BlackBrix/AKdiuno-V3/hardware/dual AK4493 DAC/XMOS_AK4118_1-Large.jpg

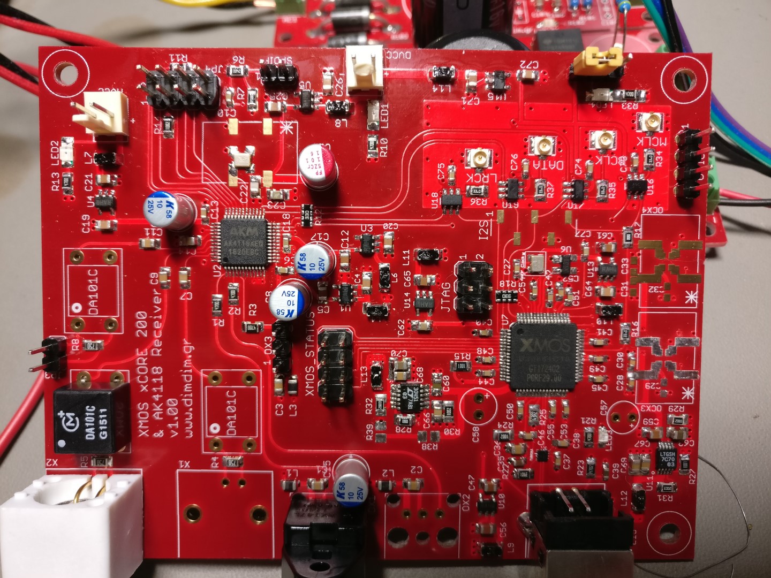
hardware/dual AK4493 DAC/XMOS_AK4118_1-Large.jpg
