BlackBrix/AKdiuno-V3/hardware/controller/STM32_MB_PCB_v36.png

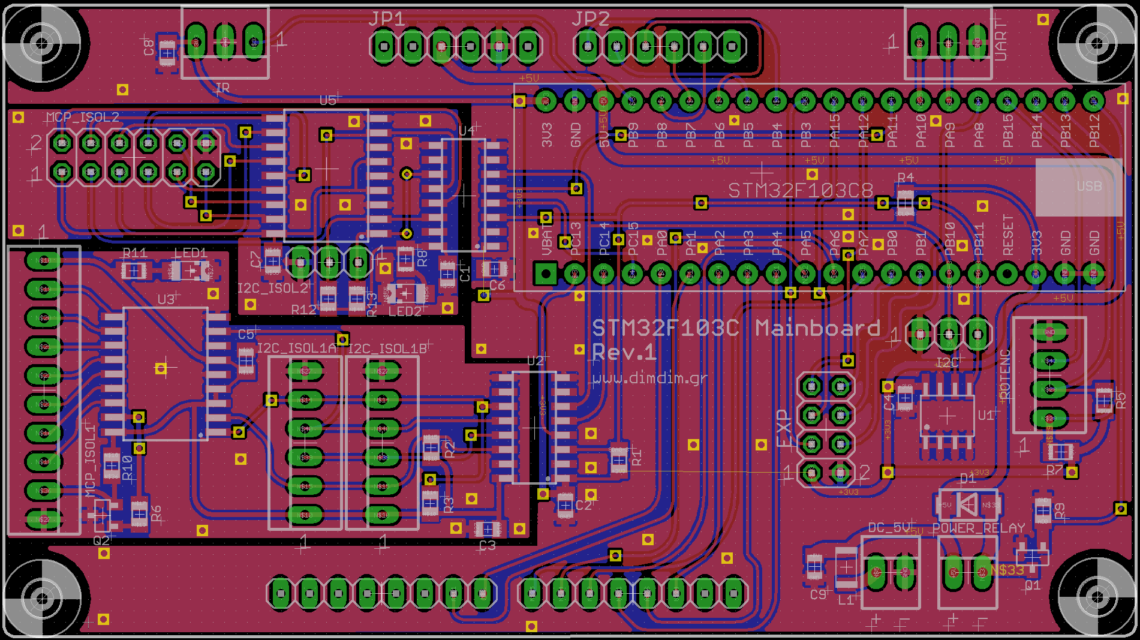
hardware/controller/STM32_MB_PCB_v36.png
