BlackBrix/AKdiuno-V3/hardware/controller/STM32_MB_Topo_v36.png

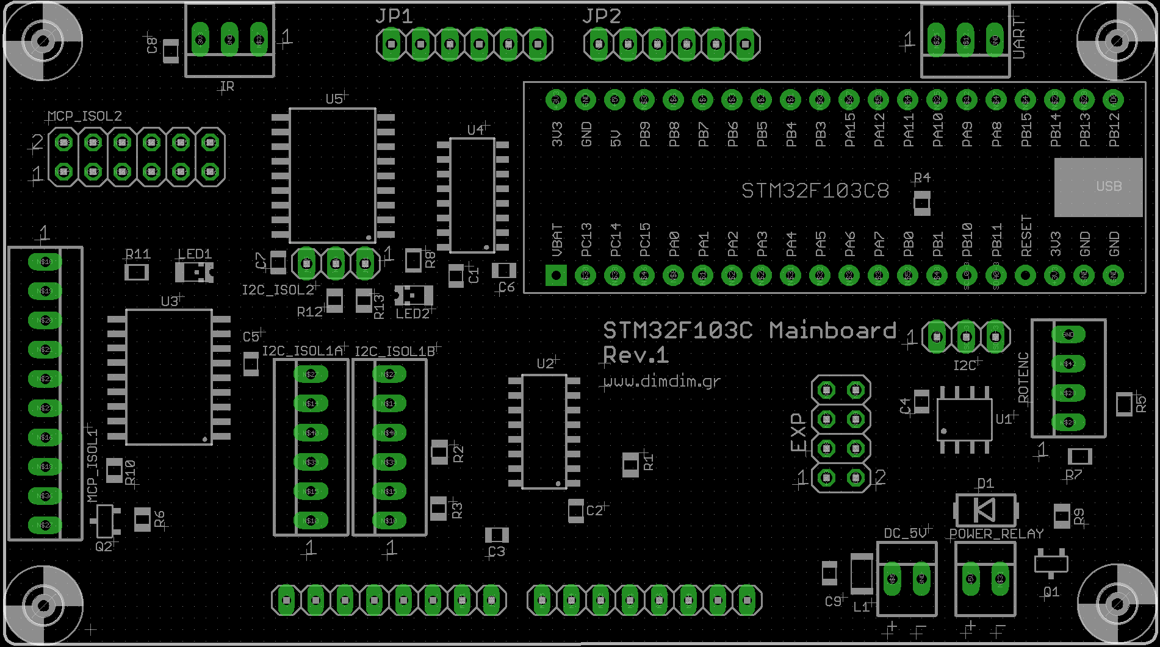
hardware/controller/STM32_MB_Topo_v36.png
