BlackBrix/AKdiuno-V3/hardware/dual AK4493 DAC/AK4493-v1.64-schematic.png

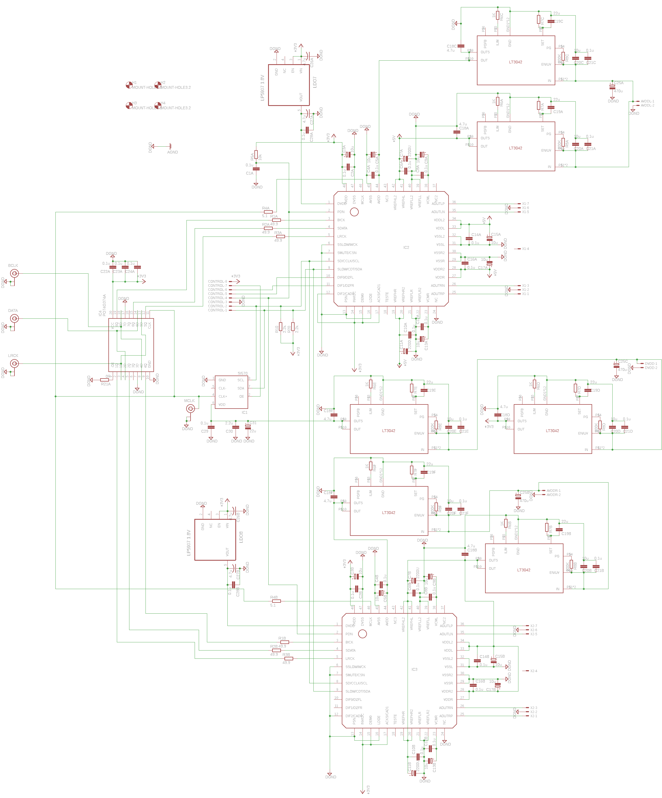
hardware/dual AK4493 DAC/AK4493-v1.64-schematic.png
