BlackBrix/AKdiuno-V3/hardware/dual AK4493 DAC/Dual_Mono_AK4493_3-Large.jpg

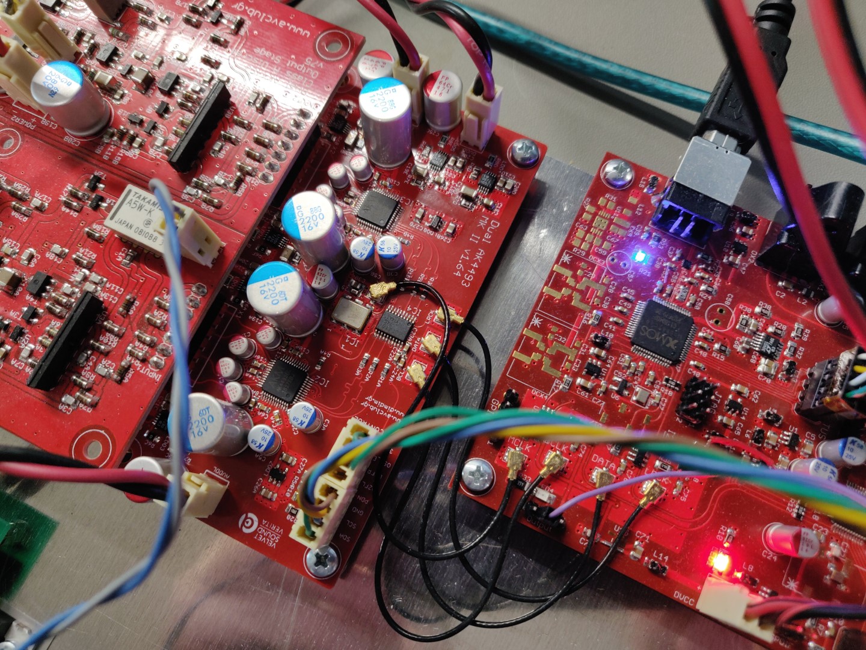
hardware/dual AK4493 DAC/Dual_Mono_AK4493_3-Large.jpg
