BlackBrix/AKdiuno-V3/hardware/Output Stage/AK4490_discreet_1-Large.jpg

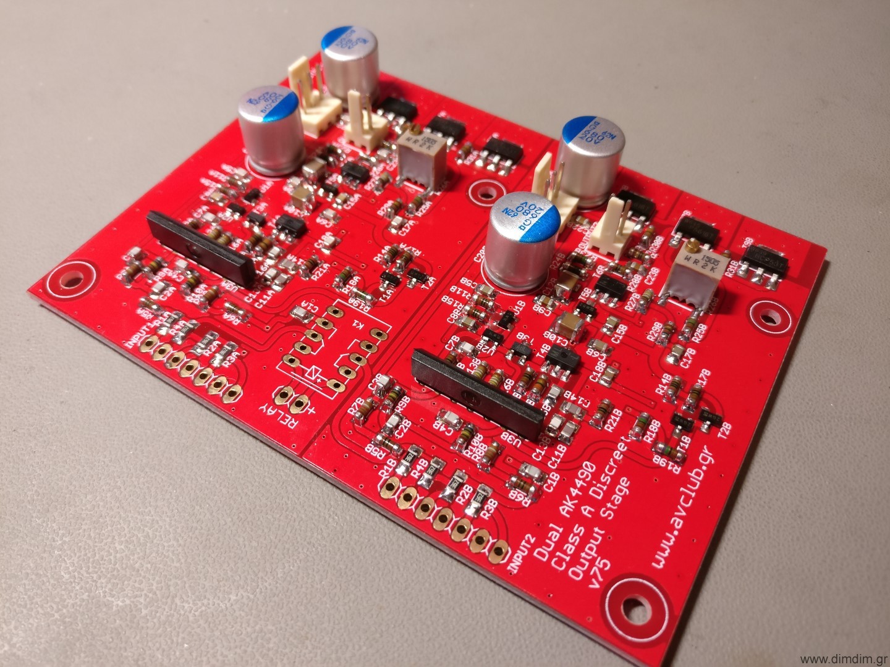
hardware/Output Stage/AK4490_discreet_1-Large.jpg
