BlackBrix/AKdiuno-V3/hardware/Output Stage/Discreet_v76_pcb.png

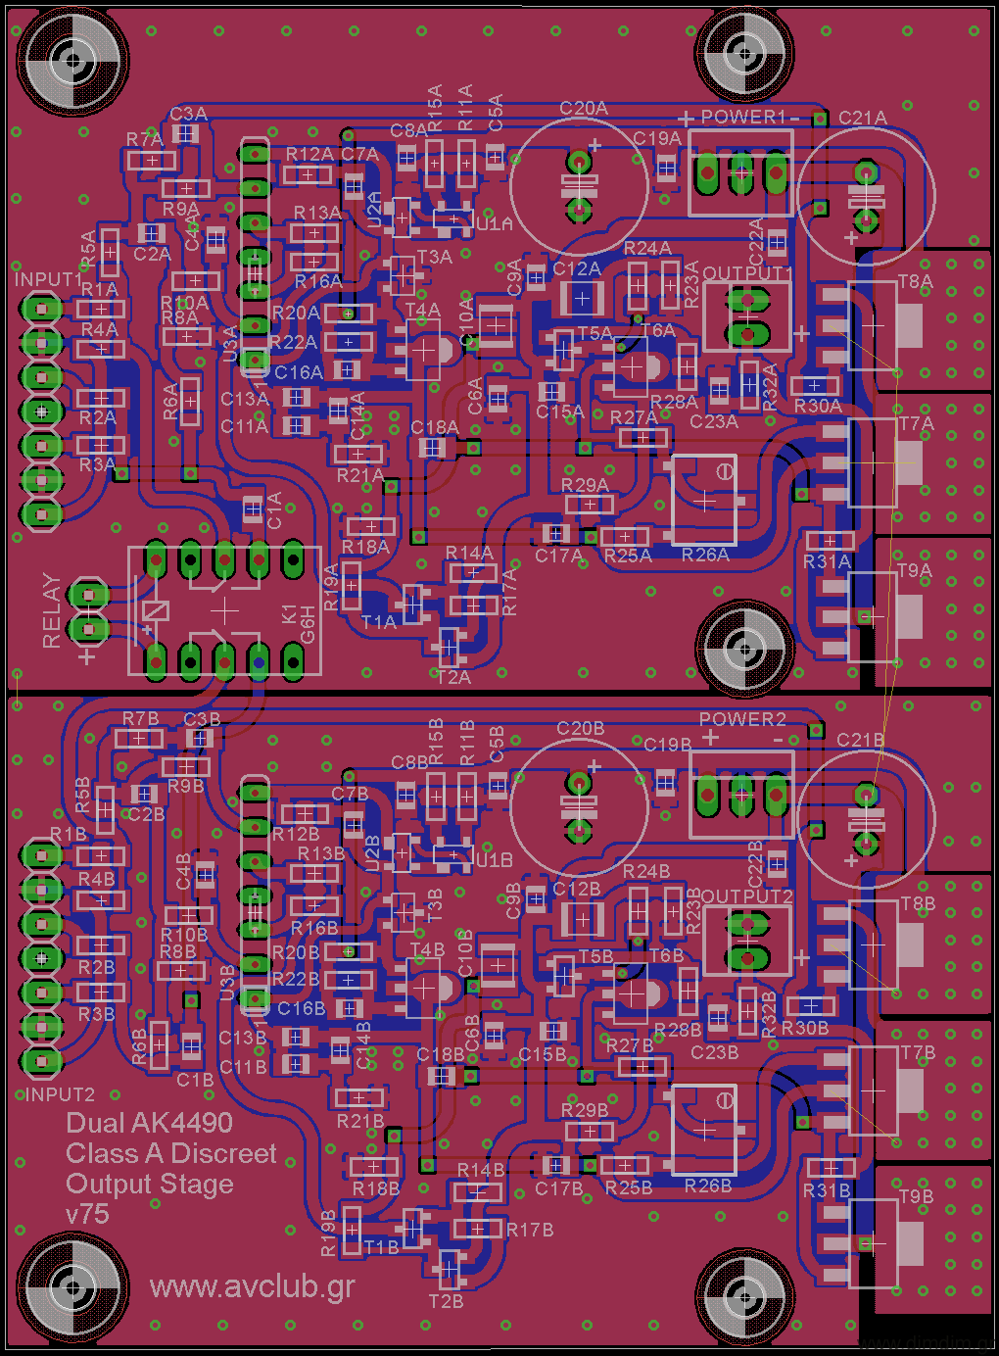
hardware/Output Stage/Discreet_v76_pcb.png
