BlackBrix/AKdiuno-V3/hardware/Output Stage/Discreet_v76_schem.png

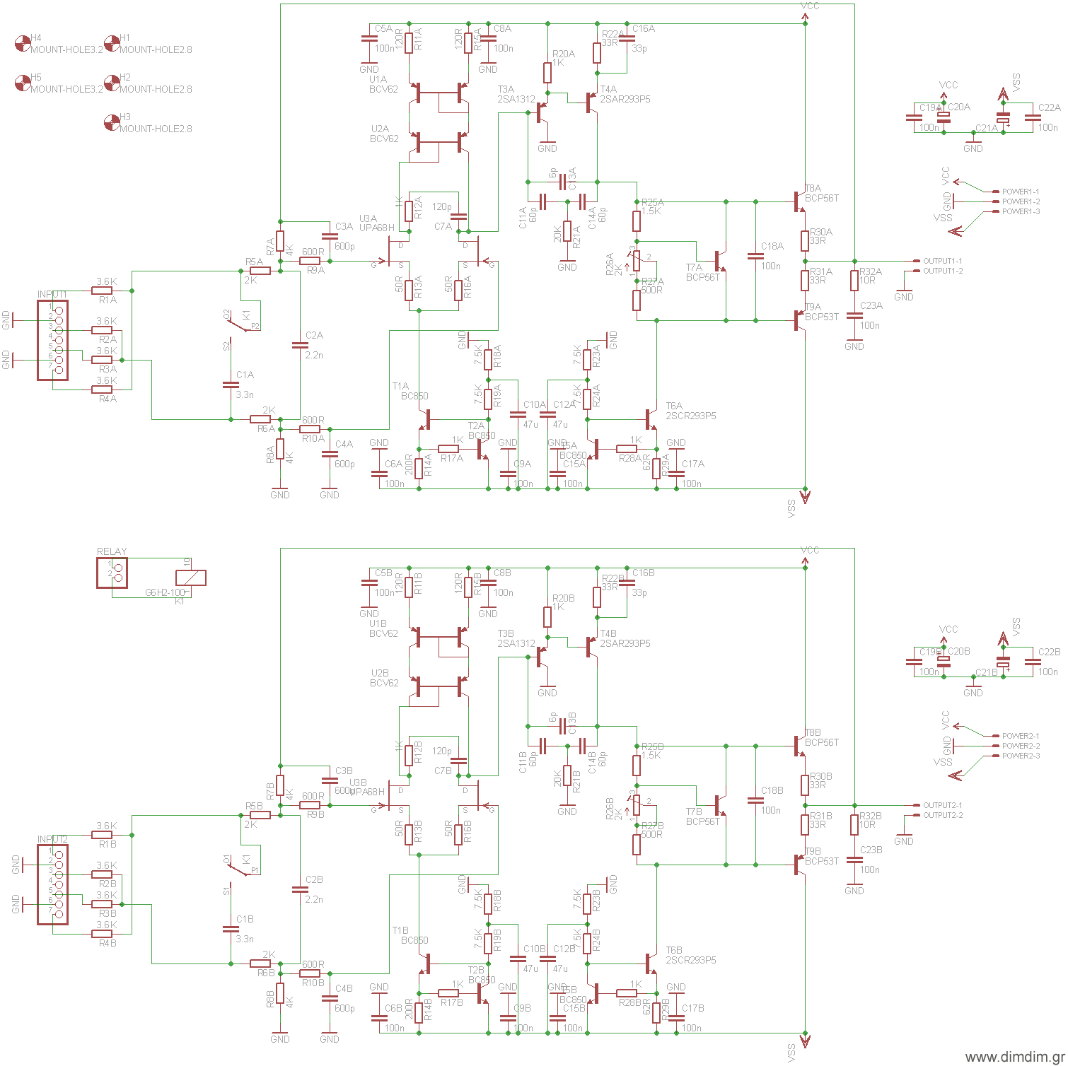
hardware/Output Stage/Discreet_v76_schem.png
