BlackBrix/AKdiuno-V3/hardware/Output Stage/BOM_output_stage.xlsx

Part | Value | Device | Package | Description | Mouser Part No. | Notes
Capacitors
C1A | 3.3n | C-EUC0805K | C0805K | Multilayer Ceramic Capacitors MLCC - SMD/SMT 50volts 3300pF 5% C0G | 80-C0805C332J5G | Critical value. +/-5% from initial value if it is necessary
C1B | 3.3n | C-EUC0805K | C0805K | Multilayer Ceramic Capacitors MLCC - SMD/SMT 50volts 3300pF 5% C0G | 80-C0805C332J5G | Critical value. +/-5% from initial value if it is necessary
C2A | 2.2n | C-EUC0805K | C0805K | Multilayer Ceramic Capacitors MLCC - SMD/SMT 50V 0.0022uF 5% C0G | 80-C0805C222J5GACTU | Critical value. +/-5% from initial value if it is necessary
C2B | 2.2n | C-EUC0805K | C0805K | Multilayer Ceramic Capacitors MLCC - SMD/SMT 50V 0.0022uF 5% C0G | 80-C0805C222J5GACTU | Critical value. +/-5% from initial value if it is necessary
C3A | 620p | C-EUC0805K | C0805K | Multilayer Ceramic Capacitors MLCC - SMD/SMT 50volts 620pF C0G 5% | 80-C0805C621J5G | Critical value. +/-5% from initial value if it is necessary
C3B | 620p | C-EUC0805K | C0805K | Multilayer Ceramic Capacitors MLCC - SMD/SMT 50volts 620pF C0G 5% | 80-C0805C621J5G | Critical value. +/-5% from initial value if it is necessary
C4A | 620p | C-EUC0805K | C0805K | Multilayer Ceramic Capacitors MLCC - SMD/SMT 50volts 620pF C0G 5% | 80-C0805C621J5G | Critical value. +/-5% from initial value if it is necessary
C4B | 620p | C-EUC0805K | C0805K | Multilayer Ceramic Capacitors MLCC - SMD/SMT 50volts 620pF C0G 5% | 80-C0805C621J5G | Critical value. +/-5% from initial value if it is necessary
C5A | 100n | C-EUC0805K | C0805K | Multilayer Ceramic Capacitors MLCC - SMD/SMT 16volts 0.1uF X7R 10% | 80-C0805C104K4R
C5B | 100n | C-EUC0805K | C0805K | Multilayer Ceramic Capacitors MLCC - SMD/SMT 16volts 0.1uF X7R 10% | 80-C0805C104K4R
C6A | 100n | C-EUC0805K | C0805K | Multilayer Ceramic Capacitors MLCC - SMD/SMT 16volts 0.1uF X7R 10% | 80-C0805C104K4R
C6B | 100n | C-EUC0805K | C0805K | Multilayer Ceramic Capacitors MLCC - SMD/SMT 16volts 0.1uF X7R 10% | 80-C0805C104K4R
C7A | 120p | C-EUC0805K | C0805K | Multilayer Ceramic Capacitors MLCC - SMD/SMT 50volts 120pF C0G 2% | 80-C0805C121G5G | Critical value. +/-5% from initial value if it is necessary
C7B | 120p | C-EUC0805K | C0805K | Multilayer Ceramic Capacitors MLCC - SMD/SMT 50volts 120pF C0G 2% | 80-C0805C121G5G | Critical value. +/-5% from initial value if it is necessary
C8A | 100n | C-EUC0805K | C0805K | Multilayer Ceramic Capacitors MLCC - SMD/SMT 16volts 0.1uF X7R 10% | 80-C0805C104K4R
C8B | 100n | C-EUC0805K | C0805K | Multilayer Ceramic Capacitors MLCC - SMD/SMT 16volts 0.1uF X7R 10% | 80-C0805C104K4R
C9A | 100n | C-EUC0805K | C0805K | Multilayer Ceramic Capacitors MLCC - SMD/SMT 16volts 0.1uF X7R 10% | 80-C0805C104K4R
C9B | 100n | C-EUC0805K | C0805K | Multilayer Ceramic Capacitors MLCC - SMD/SMT 16volts 0.1uF X7R 10% | 80-C0805C104K4R
C10A | 47u | C-EUC1210K | C1210K | Multilayer Ceramic Capacitors MLCC - SMD/SMT 47uF 10V X7R +/-10% 1210 Gen Purp | 963-LMK325B7476KM-PR
C10B | 47u | C-EUC1210K | C1210K | Multilayer Ceramic Capacitors MLCC - SMD/SMT 47uF 10V X7R +/-10% 1210 Gen Purp | 963-LMK325B7476KM-PR
C11A | 62p | C-EUC0805K | C0805K | Multilayer Ceramic Capacitors MLCC - SMD/SMT 50volts 62pF C0G 5% | 80-C0805C620J5G | Critical value. +/-5% from initial value if it is necessary
C11B | 62p | C-EUC0805K | C0805K | Multilayer Ceramic Capacitors MLCC - SMD/SMT 50volts 62pF C0G 5% | 80-C0805C620J5G | Critical value. +/-5% from initial value if it is necessary
C12A | 47u | C-EUC1210K | C1210K | Multilayer Ceramic Capacitors MLCC - SMD/SMT 47uF 10V X7R +/-10% 1210 Gen Purp | 963-LMK325B7476KM-PR
C12B | 47u | C-EUC1210K | C1210K | Multilayer Ceramic Capacitors MLCC - SMD/SMT 47uF 10V X7R +/-10% 1210 Gen Purp | 963-LMK325B7476KM-PR
C13A | 6p | C-EUC0805K | C0805K | Multilayer Ceramic Capacitors MLCC - SMD/SMT 50volts 6.2pF C0G 0.5% | 80-C0805C629D5G | Critical value. +/-5% from initial value if it is necessary
C13B | 6p | C-EUC0805K | C0805K | Multilayer Ceramic Capacitors MLCC - SMD/SMT 50volts 6.2pF C0G 0.5% | 80-C0805C629D5G | Critical value. +/-5% from initial value if it is necessary
C14A | 62p | C-EUC0805K | C0805K | Multilayer Ceramic Capacitors MLCC - SMD/SMT 50volts 62pF C0G 5% | 80-C0805C620J5G | Critical value. +/-5% from initial value if it is necessary
C14B | 62p | C-EUC0805K | C0805K | Multilayer Ceramic Capacitors MLCC - SMD/SMT 50volts 62pF C0G 5% | 80-C0805C620J5G | Critical value. +/-5% from initial value if it is necessary
C15A | 100n | C-EUC0805K | C0805K | Multilayer Ceramic Capacitors MLCC - SMD/SMT 16volts 0.1uF X7R 10% | 80-C0805C104K4R
C15B | 100n | C-EUC0805K | C0805K | Multilayer Ceramic Capacitors MLCC - SMD/SMT 16volts 0.1uF X7R 10% | 80-C0805C104K4R
C16A | 33p | C-EUC0805K | C0805K | Multilayer Ceramic Capacitors MLCC - SMD/SMT 100volts 33pF 5% C0G | 80-C0805C330J1GAC | Critical value. +/-5% from initial value if it is necessary
C16B | 33p | C-EUC0805K | C0805K | Multilayer Ceramic Capacitors MLCC - SMD/SMT 100volts 33pF 5% C0G | 80-C0805C330J1GAC | Critical value. +/-5% from initial value if it is necessary
C17A | 100n | C-EUC0805K | C0805K | Multilayer Ceramic Capacitors MLCC - SMD/SMT 16volts 0.1uF X7R 10% | 80-C0805C104K4R
C17B | 100n | C-EUC0805K | C0805K | Multilayer Ceramic Capacitors MLCC - SMD/SMT 16volts 0.1uF X7R 10% | 80-C0805C104K4R
C18A | 100n | C-EUC0805K | C0805K | Multilayer Ceramic Capacitors MLCC - SMD/SMT 16volts 0.1uF X7R 10% | 80-C0805C104K4R
C18B | 100n | C-EUC0805K | C0805K | Multilayer Ceramic Capacitors MLCC - SMD/SMT 16volts 0.1uF X7R 10% | 80-C0805C104K4R
C19A | 100n | C-EUC0805K | C0805K | Multilayer Ceramic Capacitors MLCC - SMD/SMT 16volts 0.1uF X7R 10% | 80-C0805C104K4R
C19B | 100n | C-EUC0805K | C0805K | Multilayer Ceramic Capacitors MLCC - SMD/SMT 16volts 0.1uF X7R 10% | 80-C0805C104K4R
C20A | 680u | CPOL-EUE3.5-10 | E3,5-10 | Aluminium Organic Polymer Capacitors 20Volts 680uF 0.2 | 661-APSG200E681MJB5S
C20B | 680u | CPOL-EUE3.5-10 | E3,5-10 | Aluminium Organic Polymer Capacitors 20Volts 680uF 0.2 | 661-APSG200E681MJB5S
C21A | 680u | CPOL-EUE3.5-10 | E3,5-10 | Aluminium Organic Polymer Capacitors 20Volts 680uF 0.2 | 661-APSG200E681MJB5S
C21B | 680u | CPOL-EUE3.5-10 | E3,5-10 | Aluminium Organic Polymer Capacitors 20Volts 680uF 0.2 | 661-APSG200E681MJB5S
C22A | 100n | C-EUC0805K | C0805K | Multilayer Ceramic Capacitors MLCC - SMD/SMT 16volts 0.1uF X7R 10% | 80-C0805C104K4R
C22B | 100n | C-EUC0805K | C0805K | Multilayer Ceramic Capacitors MLCC - SMD/SMT 16volts 0.1uF X7R 10% | 80-C0805C104K4R
C23A | 100n | C-EUC0805K | C0805K | Multilayer Ceramic Capacitors MLCC - SMD/SMT 16volts 0.1uF X7R 10% | 80-C0805C104K4R
C23B | 100n | C-EUC0805K | C0805K | Multilayer Ceramic Capacitors MLCC - SMD/SMT 16volts 0.1uF X7R 10% | 80-C0805C104K4R
Resistors
R1A | 3.6K | R-EU_MELF0204W | MINI_MELF-0204W | MELF Resistors 0.4W 3.6Kohms 1% 0204 MELF 150V 50ppm | 594-MMA02040C3601FB3 | Critical value. +/-10% from initial value if it is necessary
R1B | 3.6K | R-EU_MELF0204W | MINI_MELF-0204W | MELF Resistors 0.4W 3.6Kohms 1% 0204 MELF 150V 50ppm | 594-MMA02040C3601FB3 | Critical value. +/-10% from initial value if it is necessary
R2A | 3.6K | R-EU_MELF0204W | MINI_MELF-0204W | MELF Resistors 0.4W 3.6Kohms 1% 0204 MELF 150V 50ppm | 594-MMA02040C3601FB3 | Critical value. +/-10% from initial value if it is necessary
R2B | 3.6K | R-EU_MELF0204W | MINI_MELF-0204W | MELF Resistors 0.4W 3.6Kohms 1% 0204 MELF 150V 50ppm | 594-MMA02040C3601FB3 | Critical value. +/-10% from initial value if it is necessary
R3A | 3.6K | R-EU_MELF0204W | MINI_MELF-0204W | MELF Resistors 0.4W 3.6Kohms 1% 0204 MELF 150V 50ppm | 594-MMA02040C3601FB3 | Critical value. +/-10% from initial value if it is necessary
R3B | 3.6K | R-EU_MELF0204W | MINI_MELF-0204W | MELF Resistors 0.4W 3.6Kohms 1% 0204 MELF 150V 50ppm | 594-MMA02040C3601FB3 | Critical value. +/-10% from initial value if it is necessary
R4A | 3.6K | R-EU_MELF0204W | MINI_MELF-0204W | MELF Resistors 0.4W 3.6Kohms 1% 0204 MELF 150V 50ppm | 594-MMA02040C3601FB3 | Critical value. +/-10% from initial value if it is necessary
R4B | 3.6K | R-EU_MELF0204W | MINI_MELF-0204W | MELF Resistors 0.4W 3.6Kohms 1% 0204 MELF 150V 50ppm | 594-MMA02040C3601FB3 | Critical value. +/-10% from initial value if it is necessary
R5A | 2K | R-EU_MELF0204W | MINI_MELF-0204W | MELF Resistors 0.4W 2Kohms 1% 0204 MELF 200V 50ppm | 594-MMA02040C2001FB3 | Critical value. +/-5% from initial value if it is necessary
R5B | 2K | R-EU_MELF0204W | MINI_MELF-0204W | MELF Resistors 0.4W 2Kohms 1% 0204 MELF 200V 50ppm | 594-MMA02040C2001FB3 | Critical value. +/-5% from initial value if it is necessary
R6A | 2K | R-EU_MELF0204W | MINI_MELF-0204W | MELF Resistors 0.4W 2Kohms 1% 0204 MELF 200V 50ppm | 594-MMA02040C2001FB3 | Critical value. +/-5% from initial value if it is necessary
R6B | 2K | R-EU_MELF0204W | MINI_MELF-0204W | MELF Resistors 0.4W 2Kohms 1% 0204 MELF 200V 50ppm | 594-MMA02040C2001FB3 | Critical value. +/-5% from initial value if it is necessary
R7A | 4K | R-EU_MELF0204W | MINI_MELF-0204W | MELF Resistors 0.4W 4.02Kohms 1% 0204 MELF 200V 50ppm | 594-MMA02040C4021FB3 | Critical value. +/-5% from initial value if it is necessary
R7B | 4K | R-EU_MELF0204W | MINI_MELF-0204W | MELF Resistors 0.4W 4.02Kohms 1% 0204 MELF 200V 50ppm | 594-MMA02040C4021FB3 | Critical value. +/-5% from initial value if it is necessary
R8A | 4K | R-EU_MELF0204W | MINI_MELF-0204W | MELF Resistors 0.4W 4.02Kohms 1% 0204 MELF 200V 50ppm | 594-MMA02040C4021FB3 | Critical value. +/-5% from initial value if it is necessary
R8B | 4K | R-EU_MELF0204W | MINI_MELF-0204W | MELF Resistors 0.4W 4.02Kohms 1% 0204 MELF 200V 50ppm | 594-MMA02040C4021FB3 | Critical value. +/-5% from initial value if it is necessary
R9A | 600R | R-EU_MELF0204W | MINI_MELF-0204W | MELF Resistors 0.4W 604ohms 1% 0204 MELF 200V 50ppm | 594-MMA02040C6040FB3 | Critical value. +/-5% from initial value if it is necessary
R9B | 600R | R-EU_MELF0204W | MINI_MELF-0204W | MELF Resistors 0.4W 604ohms 1% 0204 MELF 200V 50ppm | 594-MMA02040C6040FB3 | Critical value. +/-5% from initial value if it is necessary
R10A | 600R | R-EU_MELF0204W | MINI_MELF-0204W | MELF Resistors 0.4W 604ohms 1% 0204 MELF 200V 50ppm | 594-MMA02040C6040FB3 | Critical value. +/-5% from initial value if it is necessary
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
R22A | 33R | R-EU_MELF0204W | MINI_MELF-0204W | MELF Resistors 0.4W 33ohms 1% 0204 MELF 200V 50ppm | 594-MMA02040C3309FB3 | Critical value. +/-5% from initial value if it is necessary
R22B | 33R | R-EU_MELF0204W | MINI_MELF-0204W | MELF Resistors 0.4W 33ohms 1% 0204 MELF 200V 50ppm | 594-MMA02040C3309FB3 | Critical value. +/-5% from initial value if it is necessary
R23A | 7.5K | R-EU_MELF0204W | MINI_MELF-0204W | MELF Resistors 0.4W 7.5Kohms 1% 0204 MELF 200V 50ppm | 594-MMA02040C7501FB3 | Critical value. +/-10% from initial value if it is necessary
R23B | 7.5K | R-EU_MELF0204W | MINI_MELF-0204W | MELF Resistors 0.4W 7.5Kohms 1% 0204 MELF 200V 50ppm | 594-MMA02040C7501FB3 | Critical value. +/-10% from initial value if it is necessary
R24A | 7.5K | R-EU_MELF0204W | MINI_MELF-0204W | MELF Resistors 0.4W 7.5Kohms 1% 0204 MELF 200V 50ppm | 594-MMA02040C7501FB3 | Critical value. +/-10% from initial value if it is necessary
R24B | 7.5K | R-EU_MELF0204W | MINI_MELF-0204W | MELF Resistors 0.4W 7.5Kohms 1% 0204 MELF 200V 50ppm | 594-MMA02040C7501FB3 | Critical value. +/-10% from initial value if it is necessary
R25A | 1.5K | R-EU_MELF0204W | MINI_MELF-0204W | MELF Resistors 0.4W 1.5Kohms 1% 0204 MELF 200V 50ppm | 594-MMA02040C1501FB0 | Critical value. +/-10% from initial value if it is necessary
R25B | 1.5K | R-EU_MELF0204W | MINI_MELF-0204W | MELF Resistors 0.4W 1.5Kohms 1% 0204 MELF 200V 50ppm | 594-MMA02040C1501FB0 | Critical value. +/-10% from initial value if it is necessary
R26A | 2K | R-TRIMMTS63Y | RTRIMTS63Y | Trimmer Resistors - SMD 2K ohm 10% 6.35mm | 858-84WR2KLF | Adjust to 1K before soldering to the board.
R26B | 2K | R-TRIMMTS63Y | RTRIMTS63Y | Trimmer Resistors - SMD 2K ohm 10% 6.35mm | 858-84WR2KLF | Adjust to 1K before soldering to the board.
R27A | 500R | R-EU_MELF0204W | MINI_MELF-0204W | MELF Resistors 0.4W 499ohms 1% 0204 MELF 150V 50ppm | 594-MMA02040C4990FB3 | Critical value. +/-10% from initial value if it is necessary
R27B | 500R | R-EU_MELF0204W | MINI_MELF-0204W | MELF Resistors 0.4W 499ohms 1% 0204 MELF 150V 50ppm | 594-MMA02040C4990FB3 | Critical value. +/-10% from initial value if it is necessary
R28A | 1K | R-EU_MELF0204W | MINI_MELF-0204W | MELF Resistors 0.4W 1Kohms 1% 0204 MELF 200V 50ppm | 594-MMA02040C1001FB3 | Critical value. +/-10% from initial value if it is necessary
R28B | 1K | R-EU_MELF0204W | MINI_MELF-0204W | MELF Resistors 0.4W 1Kohms 1% 0204 MELF 200V 50ppm | 594-MMA02040C1001FB3 | Critical value. +/-10% from initial value if it is necessary
R29A | 62R | R-EU_MELF0204W | MINI_MELF-0204W | MELF Resistors 0.4W 62ohms 1% 0204 MELF 200V 50ppm | 594-MMA02040C6209FB3 | Critical value. +/-5% from initial value if it is necessary
R29B | 62R | R-EU_MELF0204W | MINI_MELF-0204W | MELF Resistors 0.4W 62ohms 1% 0204 MELF 200V 50ppm | 594-MMA02040C6209FB3 | Critical value. +/-5% from initial value if it is necessary
R30A | 33R | R-EU_MELF0204W | MINI_MELF-0204W | MELF Resistors 0.4W 33ohms 1% 0204 MELF 200V 50ppm | 594-MMA02040C3309FB3 | Critical value. +/-5% from initial value if it is necessary
R30B | 33R | R-EU_MELF0204W | MINI_MELF-0204W | MELF Resistors 0.4W 33ohms 1% 0204 MELF 200V 50ppm | 594-MMA02040C3309FB3 | Critical value. +/-5% from initial value if it is necessary
R31A | 33R | R-EU_MELF0204W | MINI_MELF-0204W | MELF Resistors 0.4W 33ohms 1% 0204 MELF 200V 50ppm | 594-MMA02040C3309FB3 | Critical value. +/-5% from initial value if it is necessary
R31B | 33R | R-EU_MELF0204W | MINI_MELF-0204W | MELF Resistors 0.4W 33ohms 1% 0204 MELF 200V 50ppm | 594-MMA02040C3309FB3 | Critical value. +/-5% from initial value if it is necessary
R32A | 10R | R-EU_MELF0204W | MINI_MELF-0204W | MELF Resistors 0.4W 10ohms 1% 0204 MELF 200V 50ppm | 594-MMA02040C1009FB3 | Critical value. +/-5% from initial value if it is necessary
R32B | 10R | R-EU_MELF0204W | MINI_MELF-0204W | MELF Resistors 0.4W 10ohms 1% 0204 MELF 200V 50ppm | 594-MMA02040C1009FB3 | Critical value. +/-5% from initial value if it is necessary
Semiconductors
T1A | BC850 | BC850 | SOT23 | Bipolar Transistors - BJT TRANS LOW NOISE | 771-BC850C235
T1B | BC850 | BC850 | SOT23 | Bipolar Transistors - BJT TRANS LOW NOISE | 771-BC850C235
T2A | BC850 | BC850 | SOT23 | Bipolar Transistors - BJT TRANS LOW NOISE | 771-BC850C235
T2B | BC850 | BC850 | SOT23 | Bipolar Transistors - BJT TRANS LOW NOISE | 771-BC850C235
T3A | 2SA1312 | 2SA1312 | SC59-BEC | Bipolar Transistors - BJT PNP Trans -0.1A LN -120V VCEO | 757-2SA1312BLTE85LF
T3B | 2SA1312 | 2SA1312 | SC59-BEC | Bipolar Transistors - BJT PNP Trans -0.1A LN -120V VCEO | 757-2SA1312BLTE85LF
T4A | 2SAR293P5 | 2SAR293P5 | SOT89 | Bipolar Transistors - BJT PNP -30V Vceo -1A Ic MPT3 | 755-2SAR293P5T100
T4B | 2SAR293P5 | 2SAR293P5 | SOT89 | Bipolar Transistors - BJT PNP -30V Vceo -1A Ic MPT3 | 755-2SAR293P5T100
T5A | BC850 | BC850 | SOT23 | Bipolar Transistors - BJT TRANS LOW NOISE | 771-BC850C235
T5B | BC850 | BC850 | SOT23 | Bipolar Transistors - BJT TRANS LOW NOISE | 771-BC850C235
T6A | 2SCR293P5 | 2SCR293P5 | SOT89 | Bipolar Transistors - BJT NPN 30V Vceo 1A Ic MPT3 | 755-2SCR293P5T100
T6B | 2SCR293P5 | 2SCR293P5 | SOT89 | Bipolar Transistors - BJT NPN 30V Vceo 1A Ic MPT3 | 755-2SCR293P5T100
T7A | BCP56T | BCP56T | SOT-23 | Bipolar Transistors - BJT BCP56-16T/SC-73/REEL 7" Q1/T1 | 771-BCP56-16TX
T7B | BCP56T | BCP56T | SOT-23 | Bipolar Transistors - BJT BCP56-16T/SC-73/REEL 7" Q1/T1 | 771-BCP56-16TX
T8A | BCP56T | BCP56T | SOT-23 | Bipolar Transistors - BJT BCP56-16T/SC-73/REEL 7" Q1/T1 | 771-BCP56-16TX | Matched with T9A
T8B | BCP56T | BCP56T | SOT-23 | Bipolar Transistors - BJT BCP56-16T/SC-73/REEL 7" Q1/T1 | 771-BCP56-16TX | Matched with T9B
T9A | BCP53T | BCP53T | SOT-23 | Bipolar Transistors - BJT BCP53T/SC-73/REEL 7" Q1/T1 *ST | 771-BCP53TX | Matched with T8A
T9B | BCP53T | BCP53T | SOT-23 | Bipolar Transistors - BJT BCP53T/SC-73/REEL 7" Q1/T1 *ST | 771-BCP53TX | Matched with T8B
U1A | BCV62 | BCV62 | SOT143(B) | Bipolar Transistors - BJT PNP 30V 100mA | 771-BCV62C-T/R
U1B | BCV62 | BCV62 | SOT143(B) | Bipolar Transistors - BJT PNP 30V 100mA | 771-BCV62C-T/R
U2A | BCV62 | BCV62 | SOT143(B) | Bipolar Transistors - BJT PNP 30V 100mA | 771-BCV62C-T/R
U2B | BCV62 | BCV62 | SOT143(B) | Bipolar Transistors - BJT PNP 30V 100mA | 771-BCV62C-T/R
U3A | UPA68H | UPA68H | SIP7 | UPA68HA (new-old-stock part) |  | Get from Ebay
U3B | UPA68H | UPA68H | SIP7 | UPA68HA (new-old-stock part) |  | Get from Ebay
Relay
K1 | A5W-K DIP-10 | G6H2-100 | G6H2-100 | Takamisawa DPDT DIP-10 relay, 5V
Headers
INPUT1 |  | PINHD-1X7 | 1X07 | .100 (2.54mm) Center Header - 7 Pin"
INPUT2 |  | PINHD-1X7 | 1X07 | .100 (2.54mm) Center Header - 7 Pin"
OUTPUT1 |  | 22-23-2021 | 22-23-2021 | .100 (2.54mm) Center Header - 2 Pin"
OUTPUT2 |  | 22-23-2021 | 22-23-2021 | .100 (2.54mm) Center Header - 2 Pin"
POWER1 |  | 22-23-2031 | 22-23-2031 | .100 (2.54mm) Center Header - 3 Pin"
POWER2 |  | 22-23-2031 | 22-23-2031 | .100 (2.54mm) Center Header - 3 Pin"
RELAY |  | PINHD-1X2 | 1X02 | .100 (2.54mm) Center Header - 2 Pin"
