BlackBrix/AKdiuno-V3/hardware/dual AK4493 DAC/BOM_AK4493-Dual-Mono-v164-BoM-v0.5.xlsx

Qty | Part | Value | Package | Description | Source
ICs
1 | IC1 | SI544 | 8-PIN | Si544, CMOS output, 5mm x 7mm | Mouser
2 | IC2, IC3 | AK4493EQ | TQFP48_NARROW | AK4493EQ DAC | Aliexpress.com
1 | IC4 | PO74G374A | TSSOP20 | Flip-Flop | Ebay
6 | LDO1, LDO2, LDO3, LDO4, LDO5, LDO6 | LT3042 | MSOP-10 | LDO | Mouser / Farnell / Arrow
2 | LDO7, LDO8 | LP5907 1.8V | SOT-95 | LDO
Resistors
6 | R1A, R1B, R2A, R2B, R3A, R3B | 33R | M0603 | Resistor 1% | Mouser RT0603FRE0733RL
2 | R4A, R4B | 5,1R | M0603 | Resistor 1% | Mouser RT0603DRE075R1L
1 | R5A | 10K | M0805 | Resistor 1%
6 | R6A, R6B, R6C, R6D, R6E, R6F | 0R | M0805 | Resistor 1%
2 | R7A, R7B | ~51K | M0805 | Resistor, Voltage Setting, 0.1% | Mouser CPF0805B51KE1
4 | R7C, R7D, R7E, R7F | ~33K | M0805 | Resistor, Voltage Setting, 1% | Mouser
6 | R8A, R8B, R8C, R8D, R8E, R8F | 200K | M0805 | Resistor 1% | Mouser 754-RR1220P-204D
2 | R10, R20 | 2.2k | M0805 | Resistor 1%
1 | R21A | no part | M0805 | Resistor 1%
Capacitors
7 | C1A, C21A, C21B, C21C,C21D, C21E, C21F | 0.1u | C0805K | Ceramic Capacitor X7R
22 | C2A, C2B, C4A, C4B, C6A, C6B, C8A, C8B, C10A, C10B, C12A, C12B, C14A, C14B, C16A, C16B, C22A, C23A, C24A, C28A, C28B, C29 | 0.1u | C0603K | Ceramic Capacitor X7R
4 | C3A, C3B, C5A, C5B | 10u 6.3V or more | E2,5-5 | Organic Polymer Capacitor | Mouser 80-A758BG106M1EAAE70
4 | C7A, C7B, C11A, C11B | 2200U 10V or more | E5-8,5 | Organic Polymer Capacitor | Mouser 661-APSG160E222MJ20S
8 | C9A, C9B, C13A, C13B, C15A, C15B, C17A, C17B | 10u 10V or more | E2-4 | Organic Polymer Capacitor | Mouser 647-RNU1A100MDSASQ
2 | C18A, C18B | 10u | C0805K | Ceramic Capacitor X7R
4 | C18C, C18D, C18E, C18F | 4.7u-10u | C0805K | Ceramic Capacitor X7R
6 | C19A, C19B, C19C, C19D, C19E, C19F | 10-22u | C1206K | Ceramic Capacitor X7R | Mouser 963-EMK316BB7226ML-T
6 | C20A, C20B, C20C, C20D, C20E, C20F | 10u | C0805K | Ceramic Capacitor X7R
3 | C25A, C25B, C25C | 470u 10V or more | E2,5-7 | Organic Polymer Capacitor | Mouser 647-RNE1C471MDN1PX
1 | C26A, C26B, C27A, C27B | 4.7u | C0805K | Ceramic Capacitor X7R
1 | C30 | 2.2u | C0805K | Ceramic Capacitor X7R
1 | C31 | 22u | E2,5-5 | Organic Polymer Capacitor
Connectors, etc.
4 | BCLK, DATA, LRCK, MCLK | U.FL | U.FL | U.FL Female SMD
2 | X1, X2 |  | 22-23-2071 | .100 (2.54mm) Center Header - 7 Pin
1 | I2C |  | 22-23-2081 | .100 (2.54mm) Center Header - 8 Pin
3 | DVDD, AVDDL, AVDDR |  | 22-23-2021 | .100 (2.54mm) Center Header - 2 Pin"
