BlackBrix/AKdiuno-V3/Arimo_100.h

// Created by http://oleddisplay.squix.ch/ Consider a donation
// In case of problems make sure that you are using the font file with the correct version!
const uint8_t Arimo_Regular_100Bitmaps[] PROGMEM = {

	// Bitmap Data:
	0x00, // ' '
	0xFF,0xFF,0xFF,0xFF,0xFF,0xFF,0xFF,0xFF,0xFF,0xFF,0xFF,0xFF,0xFF,0xFF,0xFF,0xFF,0x9F,0xE7,0xF9,0xFE,0x7F,0x9F,0xE7,0xF9,0xFE,0x7F,0x9F,0xE7,0xF9,0xFE,0x7F,0x9F,0xE7,0xF9,0xFE,0x7F,0x9F,0xE7,0xF9,0xFE,0x7F,0x9F,0xE7,0xF9,0xFE,0x7F,0x9F,0xE7,0xF9,0xFE,0x7F,0x9F,0xE7,0xF9,0xFE,0x7F,0x9F,0xE7,0xF9,0xFE,0x7F,0x80,0x00,0x00,0x00,0x00,0x00,0x00,0x00,0x00,0x00,0x00,0x00,0x03,0xFF,0xFF,0xFF,0xFF,0xFF,0xFF,0xFF,0xFF,0xFF,0xFF,0xFF,0xFF,0xC0, // '!'
	0xFF,0x80,0x1F,0xFF,0xF8,0x01,0xFE,0xFF,0x80,0x1F,0xEF,0xF8,0x01,0xFE,0x7F,0x80,0x1F,0xE7,0xF8,0x01,0xFE,0x7F,0x80,0x1F,0xE7,0xF8,0x01,0xFE,0x7F,0x80,0x1F,0xE7,0xF8,0x01,0xFE,0x7F,0x80,0x1F,0xE7,0xF8,0x01,0xFE,0x7F,0x80,0x1F,0xE7,0xF8,0x01,0xFE,0x7F,0x80,0x1F,0xE7,0xF8,0x01,0xFE,0x7F,0x00,0x1F,0xE7,0xF0,0x01,0xFE,0x7F,0x00,0x1F,0xE7,0xF0,0x01,0xFE,0x7F,0x00,0x0F,0xE7,0xF0,0x00,0xFE, // '"'
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
,0xFF,0x00,0x00,0x01,0xFC,0x00,0x0F,0xE0,0x00,0x00,0xFF,0x00,0x00,0x00,0xFE,0x00,0x07,0xF0,0x00,0x00,0x7F,0x00,0x00,0x00,0x7F,0x00,0x07,0xF0,0x00,0x00,0x7F,0x80,0x00,0x00,0x1F,0xC0,0x03,0xF8,0x00,0x00,0x7F,0x80,0x00,0x00,0x0F,0xF0,0x03,0xFC,0x00,0x00,0x3F,0x80,0x00,0x00,0x03,0xFC,0x03,0xFC,0x00,0x00,0x3F,0xC0,0x00,0x00,0x01,0xFF,0xCF,0xFC,0x00,0x00,0x3F,0xC0,0x00,0x00,0x00,0x7F,0xFF,0xFE,0x00,0x00,0x1F,0xC0,0x00,0x00,0x00,0x1F,0xFF,0xFE,0x00,0x00,0x1F,0xE0,0x00,0x00,0x00,0x07,0xFF,0xFC,0x00,0x00,0x0F,0xE0,0x00,0x00,0x00,0x00,0xFF,0xFC,0x00,0x00,0x00,0x00,0x00,0x00,0x00,0x00,0x0F,0xF0,0x00, // '%'
	0x00,0x00,0x00,0xFF,0xE0,0x00,0x00,0x00,0x00,0x00,0x3F,0xFF,0xE0,0x00,0x00,0x00,0x00,0x07,0xFF,0xFF,0xC0,0x00,0x00,0x00,0x00,0xFF,0xFF,0xFF,0x00,0x00,0x00,0x00,0x0F,0xFF,0xFF,0xFC,0x00,0x00,0x00,0x00,0xFF,0xFF,0xFF,0xF0,0x00,0x00,0x00,0x07,0xFF,0x01,0xFF,0xC0,0x00,0x00,0x00,0x7F,0xC0,0x03,0xFF,0x00,0x00,0x00,0x03,0xFC,0x00,0x07,0xF8,0x00,0x00,0x00,0x3F,0xC0,0x00,0x3F,0xC0,0x00,0x00,0x01,0xFE,0x00,0x00,0xFF,0x00,0x00,0x00,0x0F,0xE0,0x00,0x07,0xF8,0x00,0x00,0x00,0x7F,0x00,0x00,0x1F,0xC0,0x00,0x00,0x07,0xF8,0x00,0x00,0xFE,0x00,0x00,0x00,0x3F,0xC0,0x00,0x07,0xF0,0x00,0x00,0x01,0xFE,0x00,0x00,0x7F,0x80,0x00,0x00,0x0F,0xF0,0x00,0x03,0xFC,0x00,0x00,0x00,0x7F,0x80,0x00,0x1F,0xE0,0x00,0x00,0x01,0xFC,0x00,0x01,0xFE,0x00,0x00,0x00,0x0F,0xE0,0x00,0x1F,0xF0,0x00,0x00,0x00,0x7F,0x00,0x01,0xFF,0x00,0x00,0x00,0x03,0xFC,0x00,0x1F,0xF8,0x00,0x00,0x00,0x1F,0xE0,0x01,0xFF,0x80,0x00,0x00,0x00,0x7F,0x00,0x3F,0xF8,0x00,0x00,0x00,0x03,0xFC,0x07,0xFF,0x80,0x00,0x00,0x00,0x1F,0xE0,0xFF,0xF8,0x00,0x00,0x00,0x00,0x7F,0x9F,0xFF,0x80,0x00,0x00,0x00,0x03,0xFF,0xFF,0xF0,0x00,0x00,0x00,0x00,0x0F,0xFF,0xFF,0x00,0x00,0x00,0x00,0x00,0x7F,0xFF,0xE0,0x00,0x00,0x00,0x00,0x07,0xFF,0xFC,0x00,0x00,0x00,0x00,0x00,0xFF,0xFF,0x80,0x00,0x00,0x00,0x00,0x0F,0xFF,0xE0,0x00,0x00,0x00,0x00,0x01,0xFF,0xFE,0x00,0x00,0x03,0x00,0x00,0x3F,0xFF,0xF8,0x00,0x00,0x3F,0x00,0x03,0xFF,0xFF,0xC0,0x00,0x01,0xFE,0x00,0x3F,0xFF,0xFF,0x00,0x00,0x0F,0xF0,0x03,0xFF,0xC7,0xFC,0x00,0x00,0x7F,0x00,0x3F,0xF8,0x1F,0xE0,0x00,0x07,0xF8,0x03,0xFF,0x80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
	  { 12378,  55,  69,  68,    8,  -69 }, // 'E'
	  { 12853,  49,  69,  62,    8,  -69 }, // 'F'
	  { 13276,  66,  71,  79,    5,  -70 }, // 'G'
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
};
const GFXfont Arimo_100 PROGMEM = {
(uint8_t  *)Arimo_Regular_100Bitmaps,(GFXglyph *)Arimo_Regular_100Glyphs,0x20, 0x7E, 116};
