BlackBrix/AKdiuno-V3/Arimo_106.h

// Created by http://oleddisplay.squix.ch/ Consider a donation
// In case of problems make sure that you are using the font file with the correct version!
const uint8_t Arimo_106Bitmaps[] PROGMEM = {

	// Bitmap Data:
	0x00, // ' '
	0x00,0x3F,0xFF,0xFF,0xFF,0xFF,0xFF,0xFF,0xFF,0xFF,0xFF,0xFF,0xFF,0xFF,0xFF,0xFF,0xFF,0xFF,0xFD,0xFF,0x7F,0xDF,0xF7,0xFD,0xFF,0x7F,0xDF,0xF7,0xFD,0xFF,0x7F,0xDF,0xF7,0xFD,0xFF,0x7F,0xDF,0xF7,0xFD,0xFF,0x7F,0xDF,0xF7,0xFD,0xFF,0x7F,0x9F,0xE7,0xF9,0xFE,0x7F,0x9F,0xE7,0xF9,0xFE,0x7F,0x9F,0xE7,0xF9,0xFE,0x7F,0x9F,0xE7,0xF9,0xFE,0x7F,0x80,0x00,0x00,0x00,0x00,0x00,0x00,0x00,0x00,0x00,0x00,0x00,0x03,0xFF,0xFF,0xFF,0xFF,0xFF,0xFF,0xFF,0xFF,0xFF,0xFF,0xFF,0xFF,0xC0, // '!'
	0x00,0x00,0x00,0x1F,0xF0,0x03,0xFF,0xFE,0x00,0x7F,0xFF,0xC0,0x0F,0xFF,0xF8,0x01,0xFF,0xFF,0x00,0x3F,0xFF,0xE0,0x07,0xFF,0xFC,0x00,0xFF,0xFF,0x80,0x1F,0xFF,0xF0,0x01,0xFF,0xFE,0x00,0x3F,0xBF,0xC0,0x07,0xF7,0xF8,0x00,0xFE,0xFF,0x00,0x1F,0xDF,0xE0,0x03,0xFB,0xFC,0x00,0x7F,0x7F,0x80,0x0F,0xEF,0xF0,0x01,0xFD,0xFE,0x00,0x3F,0xBF,0xC0,0x07,0xF7,0xF8,0x00,0xFE,0xFF,0x00,0x1F,0xDF,0xC0,0x03,0xF8, // '"'
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
,0x00,0x01,0xFC,0x00,0x00,0x00,0x00,0x00,0x00,0xFE,0x00,0x00,0x00, // '$'
	0x00,0x0F,0xF8,0x00,0x00,0x00,0x00,0x00,0x00,0x00,0x00,0x00,0xFF,0xFE,0x00,0x00,0x00,0x00,0x03,0xFC,0x00,0x00,0x03,0xFF,0xFF,0x00,0x00,0x00,0x00,0x0F,0xF0,0x00,0x00,0x1F,0xFF,0xFF,0x00,0x00,0x00,0x00,0x1F,0xE0,0x00,0x00,0x7F,0xFF,0xFF,0x00,0x00,0x00,0x00,0x7F,0x80,0x00,0x01,0xFF,0xFF,0xFF,0x00,0x00,0x00,0x01,0xFE,0x00,0x00,0x03,0xFE,0x01,0xFF,0x00,0x00,0x00,0x03,0xFC,0x00,0x00,0x0F,0xF8,0x01,0xFE,0x00,0x00,0x00,0x0F,0xF0,0x00,0x00,0x1F,0xE0,0x01,0xFE,0x00,0x00,0x00,0x3F,0xC0,0x00,0x00,0x7F,0x80,0x03,0xFC,0x00,0x00,0x00,0x7F,0x80,0x00,0x00,0xFF,0x00,0x03,0xF8,0x00,0x00,0x01,0xFE,0x00,0x00,0x01,0xFC,0x00,0x07,0xF8,0x00,0x00,0x07,0xF8,0x00,0x00,0x07,0xF8,0x00,0x0F,0xF0,0x00,0x00,0x0F,0xF0,0x00,0x00,0x0F,0xF0,0x00,0x0F,0xE0,0x00,0x00,0x3F,0xC0,0x00,0x00,0x1F,0xE0,0x00,0x1F,0xC0,0x00,0x00,0xFF,0x00,0x00,0x00,0x3F,0x80,0x00,0x3F,0x80,0x00,0x01,0xFE,0x00,0x00,0x00,0x7F,0x00,0x00,0x7F,0x80,0x00,0x07,0xF8,0x00,0x00,0x00,0xFE,0x00,0x00,0xFF,0x00,0x00,0x1F,0xF0,0x00,0x00,0x03,0xFC,0x00,0x01,0xFE,0x00,0x00,0x3F,0xC0,0x00,0x00,0x07,0xF8,0x00,0x03,0xFC,0x00,0x00,0xFF,0x00,0x00,0x00,0x0F,0xF0,0x00,0x07,0xF8,0x00,0x03,0xFE,0x00,0x00,0x00,0x1F,0xE0,0x00,0x0F,0xF0,0x00,0x07,0xF8,0x00,0x00,0x00,0x3F,0xC0,0x00,0x1F,0xE0,0x00,0x1F,0xE0,0x00,0x00,0x00,0x7F,0x80,0x00,0x3F,0xC0,0x00,0x7F,0xC0,0x00,0x00,0x00,0xFF,0x00,0x00,0x7F,0x80,0x00,0xFF,0x00,0x00,0x00,0x01,0xFE,0x00,0x00,0xFF,0x00,0x03,0xFC,0x00,0x00,0x00,0x03,0xFC,0x00,0x01,0xFE,0x00,0x07,0xF8,0x00,0x00,0x00,0x07,0xF8,0x00,0x03,0xFC,0x00,0x1F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
,0xFF,0xFF,0x00,0x00,0x00,0x01,0xFF,0xFF,0xFF,0xFF,0xC0,0x00,0x00,0x00,0x07,0xFF,0xFF,0xFF,0xF0,0x00,0x00,0x00,0x00,0x1F,0xFF,0xFF,0xF8,0x00,0x00,0x00,0x00,0x00,0x1F,0xFF,0xFC,0x00,0x00,0x00, // 'C'
	0x00,0x00,0x00,0x00,0x00,0x00,0x00,0x01,0xFF,0xFF,0xFF,0xFF,0xC0,0x00,0x00,0x03,0xFF,0xFF,0xFF,0xFF,0xF8,0x00,0x00,0x07,0xFF,0xFF,0xFF,0xFF,0xFE,0x00,0x00,0x0F,0xFF,0xFF,0xFF,0xFF,0xFF,0x00,0x00,0x1F,0xFF,0xFF,0xFF,0xFF,0xFF,0xC0,0x00,0x3F,0xFF,0xFF,0xFF,0xFF,0xFF,0xC0,0x00,0x7F,0xFF,0xFF,0xFF,0xFF,0xFF,0xE0,0x00,0xFF,0xC0,0x00,0xFF,0xFF,0xFF,0xE0,0x01,0xFF,0x80,0x00,0x00,0xFF,0xFF,0xE0,0x03,0xFF,0x00,0x00,0x00,0x1F,0xFF,0xE0,0x07,0xFE,0x00,0x00,0x00,0x0F,0xFF,0xE0,0x0F,0xFC,0x00,0x00,0x00,0x03,0xFF,0xE0,0x1F,0xF8,0x00,0x00,0x00,0x03,0xFF,0xE0,0x3F,0xF0,0x00,0x00,0x00,0x03,0xFF,0xE0,0x7F,0xE0,0x00,0x00,0x00,0x03,0xFF,0xE0,0xFF,0xC0,0x00,0x00,0x00,0x03,0xFF,0xC1,0xFF,0x80,0x00,0x00,0x00,0x03,0xFF,0xC3,0xFF,0x00,0x00,0x00,0x00,0x03,0xFF,0x87,0xFE,0x00,0x00,0x00,0x00,0x03,0xFF,0x8F,0xFC,0x00,0x00,0x00,0x00,0x07,0xFF,0x1F,0xF8,0x00,0x00,0x00,0x00,0x07,0xFF,0x3F,0xF0,0x00,0x00,0x00,0x00,0x0F,0xFE,0x7F,0xE0,0x00,0x00,0x00,0x00,0x0F,0xFC,0xFF,0xC0,0x00,0x00,0x00,0x00,0x1F,0xF9,0xFF,0x80,0x00,0x00,0x00,0x00,0x3F,0xFB,0xFF,0x00,0x00,0x00,0x00,0x00,0x3F,0xF7,0xFE,0x00,0x00,0x00,0x00,0x00,0x7F,0xEF,0xFC,0x00,0x00,0x00,0x00,0x00,0xFF,0xDF,0xF8,0x00,0x00,0x00,0x00,0x01,0xFF,0xBF,0xF0,0x00,0x00,0x00,0x00,0x01,0xFF,0xFF,0xE0,0x00,0x00,0x00,0x00,0x03,0xFF,0xFF,0xC0,0x00,0x00,0x00,0x00,0x07,0xFF,0xFF,0x80,0x00,0x00,0x00,0x00,0x0F,0xFF,0xFF,0x00,0x00,0x00,0x00,0x00,0x1F,0xFF,0xFE,0x00,0x00,0x00,0x00,0x00,0x3F,0xFF,0xFC,0x00,0x00,0x00,0x00,0x00,0x7F,0xFF,0xF8,0x00,0x00,0x00,0x00,0x00,0xFF,0xFF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
	  { 13971,  58,  73,  72,    9,  -73 }, // 'E'
	  { 14501,  52,  73,  66,    9,  -73 }, // 'F'
	  { 14976,  69,  75,  83,    5,  -74 }, // 'G'
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
};
const GFXfont Arimo_106 PROGMEM = {
(uint8_t  *)Arimo_106Bitmaps,(GFXglyph *)Arimo_106Glyphs,0x20, 0x7E, 122};
