BlackBrix/AKdiuno-V3/Arimo_Bold_16.h

// Created by http://oleddisplay.squix.ch/ Consider a donation
// In case of problems make sure that you are using the font file with the correct version!
const uint8_t Arimo_Bold_16Bitmaps[] PROGMEM = {

	// Bitmap Data:
	0x00, // ' '
	0xFF,0xFF,0x03, // '!'
	0xDE,0xF7,0xB0, // '"'
	0x13,0x33,0x32,0x22,0xFF,0x26,0x66,0x64,0xFF,0x44,0x4C,0xC8, // '#'
	0x3E,0x3F,0x9A,0xCD,0x26,0x83,0xE0,0xFC,0x1F,0x09,0xB4,0xDA,0x67,0xE0,0x80, // '$'
	0x78,0x23,0x31,0x8C,0xCC,0x33,0x20,0xCD,0x83,0x35,0xE7,0xAC,0xC1,0xB3,0x04,0xCC,0x33,0x31,0x8C,0xC4,0x1E, // '%'
	0x1E,0x06,0x60,0xCC,0x1B,0x83,0xE0,0x78,0x1E,0x37,0x6C,0xCD,0x98,0xF3,0x9C,0x1F,0xF0, // '&'
	0xFF, // '''
	0x33,0x19,0xCC,0x63,0x18,0xC6,0x30,0xC6,0x30,0xC0, // '('
	0x61,0x8C,0x61,0x8C,0x63,0x18,0xC6,0x73,0x19,0x80, // ')'
	0x18,0x1A,0x7E,0x18,0x3C,0x24,0x00, // '*'
	0x18,0x18,0x18,0xFF,0x18,0x18,0x18,0x18, // '+'
	0x64,0xA0, // ','
	0xF0, // '-'
	0xC0, // '.'
	0x31,0x8C,0x62,0x31,0x8C,0x63,0x31,0x80, // '/'
	0x3C,0x66,0xC2,0xC3,0xC3,0xC3,0xC3,0xC3,0xC3,0xC2,0x66,0x3C, // '0'
	0x38,0xF3,0xE4,0xC1,0x83,0x06,0x0C,0x18,0x30,0x67,0xF0, // '1'
	0x7C,0xCB,0x18,0x30,0xE1,0xC7,0x1C,0x70,0xC3,0x87,0xF0, // '2'
	0x3E,0x73,0x63,0x03,0x07,0x1C,0x06,0x03,0x23,0x63,0x77,0x3C, // '3'
	0x0E,0x07,0x07,0x82,0xC3,0x63,0x31,0x99,0x8C,0xFF,0x83,0x01,0x80,0xC0, // '4'
	0x7E,0x60,0x60,0x60,0x60,0x7E,0x67,0x03,0x03,0x63,0x66,0x3C, // '5'
	0x3C,0x66,0x42,0xC0,0xC0,0xFE,0xE7,0xC3,0xC3,0xC3,0x66,0x3C, // '6'
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
	  {   375,   9,  12,  12,    1,  -12 }, // 'E'
	  {   389,   8,  12,  11,    1,  -12 }, // 'F'
	  {   401,  11,  12,  14,    1,  -12 }, // 'G'
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
};
const GFXfont Arimo_Bold_16 PROGMEM = {
(uint8_t  *)Arimo_Bold_16Bitmaps,(GFXglyph *)Arimo_Bold_16Glyphs,0x20, 0x7E, 19};
