BlackBrix/AKdiuno-V3/Arimo_Bold_24.h

// Created by http://oleddisplay.squix.ch/ Consider a donation
// In case of problems make sure that you are using the font file with the correct version!
const uint8_t Arimo_Bold_24Bitmaps[] PROGMEM = {

	// Bitmap Data:
	0x00, // ' '
	0xFF,0xFF,0xFF,0xFF,0x80,0x3F,0xE0, // '!'
	0xE7,0xE7,0xE7,0xE7,0xE7,0xE7, // '"'
	0x04,0x30,0x61,0x03,0x18,0x18,0xC0,0xC6,0x3F,0xFD,0xFF,0xE3,0x18,0x18,0xC0,0xC6,0x04,0x31,0xFF,0xEF,0xFF,0x18,0xC0,0xC6,0x04,0x30,0x61,0x00, // '#'
	0x02,0x00,0xFE,0x0F,0xF8,0xFF,0xE7,0x27,0x39,0x3D,0xC8,0x0F,0x40,0x3F,0x80,0xFF,0x03,0xFC,0x05,0xF0,0x23,0x91,0x1D,0xC8,0xEF,0x4F,0x3F,0xF0,0xFE,0x00,0x80, // '$'
	0x3E,0x01,0x07,0xF0,0x30,0xF7,0x06,0x0E,0x38,0x40,0xE3,0x8C,0x0E,0x39,0x80,0xE3,0x9B,0xCE,0x3B,0x7E,0xE7,0x6E,0x77,0xF6,0xE7,0x3E,0xCE,0x70,0x18,0xE7,0x01,0x8E,0x70,0x30,0xE7,0x07,0x0E,0x70,0x60,0x7E,0x0C,0x03,0xC0, // '%'
	0x07,0xC0,0x0F,0xE0,0x1C,0x70,0x1C,0x70,0x1C,0x70,0x1C,0xE0,0x0F,0xE0,0x0F,0x80,0x3E,0x08,0x7F,0x0C,0xF3,0x9C,0xE3,0x9C,0xE1,0xF8,0xE1,0xF8,0xF0,0xF8,0x7F,0xFF,0x1F,0x0F, // '&'
	0xFF,0xFF,0xC0, // '''
	0x1C,0x78,0xE3,0xC7,0x0E,0x3C,0x70,0xE1,0xC3,0x87,0x0E,0x1C,0x38,0x70,0xF0,0xE1,0xC3,0xC3,0x87,0x87,0x00, // '('
	0x70,0xF0,0xE1,0xE1,0xC3,0x87,0x07,0x0E,0x1C,0x38,0x70,0xE1,0xC3,0x87,0x1C,0x38,0x71,0xE3,0x8F,0x1C,0x00, // ')'
	0x0E,0x01,0xC1,0x39,0x3F,0xE7,0xFC,0x3E,0x0E,0xE3,0x8E,0x11,0x00, // '*'
	0x0E,0x00,0xE0,0x0E,0x00,0xE0,0x0E,0x0F,0xFF,0xFF,0xF0,0xE0,0x0E,0x00,0xE0,0x0E,0x00,0xE0, // '+'
	0xFF,0xF3,0x36,0xE0, // ','
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
	  {   789,  14,  17,  17,    2,  -17 }, // 'E'
	  {   819,  12,  17,  16,    2,  -17 }, // 'F'
	  {   845,  16,  17,  19,    1,  -17 }, // 'G'
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
};
const GFXfont Arimo_Bold_24 PROGMEM = {
(uint8_t  *)Arimo_Bold_24Bitmaps,(GFXglyph *)Arimo_Bold_24Glyphs,0x20, 0x7E, 28};
