BlackBrix/AKdiuno-V3/Arimo_Bold_26.h

// Created by http://oleddisplay.squix.ch/ Consider a donation
// In case of problems make sure that you are using the font file with the correct version!
const uint8_t Arimo_Bold_26Bitmaps[] PROGMEM = {

	// Bitmap Data:
	0x00, // ' '
	0xFF,0xFF,0xFF,0xFF,0xFF,0xFF,0x00,0x0F,0xFF, // '!'
	0xE7,0xE7,0xE7,0xE7,0xE7,0xE7, // '"'
	0x06,0x18,0x18,0xC0,0xC3,0x03,0x0C,0x0C,0x31,0xFF,0xF7,0xFF,0xC6,0x18,0x18,0x60,0x61,0x81,0x84,0x3F,0xFE,0xFF,0xF8,0xC3,0x03,0x0C,0x0C,0x60,0x31,0x81,0x86,0x00, // '#'
	0x01,0x00,0x1F,0xC0,0xFF,0xE1,0xFF,0xE7,0x93,0xCF,0x27,0x9E,0x40,0x3E,0x80,0x3F,0x00,0x7F,0xC0,0x3F,0xE0,0x1F,0xE0,0x17,0xE0,0x23,0xDC,0x47,0xBC,0x8F,0x79,0x3C,0x7F,0xF8,0x3F,0xC0,0x08,0x00,0x10,0x00, // '$'
	0x3E,0x00,0xC1,0xFC,0x06,0x0F,0x70,0x38,0x38,0xE0,0xC0,0xE3,0x86,0x03,0x8E,0x38,0x0E,0x38,0xC0,0x38,0xE6,0x7C,0xE7,0x33,0xF9,0xFC,0xDE,0xE3,0xE6,0x71,0xC0,0x31,0xC7,0x00,0xC7,0x1C,0x06,0x1C,0x70,0x30,0x71,0xC0,0xC1,0xCE,0x06,0x03,0xF8,0x30,0x07,0xC0, // '%'
	0x07,0xE0,0x07,0xF8,0x07,0x9E,0x03,0x87,0x01,0xC3,0x80,0xE3,0xC0,0x7F,0xC0,0x1F,0x80,0x1F,0x80,0x3F,0x83,0x9F,0xE3,0x9E,0x71,0xCE,0x1C,0xE7,0x0F,0xE3,0x83,0xF0,0xE0,0xF8,0x7F,0xFF,0x8F,0xC3,0xC0, // '&'
	0xFF,0xFF,0xC0, // '''
	0x0E,0x1E,0x1C,0x3C,0x78,0x78,0x78,0xF0,0xF0,0xF0,0xF0,0xF0,0xF0,0xF0,0xF0,0xF0,0xF0,0x78,0x78,0x78,0x3C,0x3C,0x1E,0x0E, // '('
	0x70,0x78,0x38,0x3C,0x1E,0x1E,0x1E,0x0F,0x0F,0x0F,0x0F,0x0F,0x0F,0x0F,0x0F,0x0F,0x0F,0x1E,0x1E,0x1E,0x3C,0x38,0x78,0x70, // ')'
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
	  {   923,  15,  18,  19,    2,  -18 }, // 'E'
	  {   957,  13,  18,  17,    2,  -18 }, // 'F'
	  {   987,  18,  18,  22,    1,  -18 }, // 'G'
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
};
const GFXfont Arimo_Bold_26 PROGMEM = {
(uint8_t  *)Arimo_Bold_26Bitmaps,(GFXglyph *)Arimo_Bold_26Glyphs,0x20, 0x7E, 31};
