BlackBrix/AKdiuno-V3/Arimo_Bold_28.h

// Created by http://oleddisplay.squix.ch/ Consider a donation
// In case of problems make sure that you are using the font file with the correct version!
const uint8_t Arimo_Bold_28Bitmaps[] PROGMEM = {

	// Bitmap Data:
	0x00, // ' '
	0xFF,0xFF,0xFF,0xFF,0xFF,0xFF,0xF0,0x00,0x0F,0xF0, // '!'
	0xF7,0xFB,0xFD,0xFE,0xFF,0x7F,0xBF,0xDE, // '"'
	0x06,0x1C,0x0C,0x30,0x18,0x60,0x30,0xC0,0xC3,0x8F,0xFF,0xDF,0xFF,0x86,0x18,0x1C,0x30,0x30,0x60,0x61,0x80,0xC3,0x0F,0xFF,0xDF,0xFF,0x8C,0x38,0x18,0x60,0x30,0xC0,0x61,0x81,0xC3,0x00, // '#'
	0x01,0x00,0x1F,0xC0,0xFF,0xE1,0xFF,0xC7,0xD7,0xCF,0x27,0x9E,0x4C,0x3C,0x80,0x7F,0x00,0x7F,0x80,0x7F,0xC0,0x7F,0xE0,0x1F,0xC0,0x27,0xC0,0x47,0xF8,0x8F,0x79,0x1E,0xF2,0x78,0xFF,0xE0,0x7F,0x80,0x10,0x00,0x20,0x00,0x40,0x00, // '$'
	0x1E,0x00,0x60,0xFF,0x01,0x81,0xCE,0x07,0x07,0x0E,0x1C,0x0E,0x1C,0x30,0x1C,0x38,0xE0,0x38,0x73,0x80,0x70,0xE6,0x7C,0xE1,0xDD,0xFC,0xE7,0x73,0xB9,0xFE,0xEE,0x38,0xF3,0x9C,0x70,0x0E,0x38,0xE0,0x1C,0x71,0xC0,0x70,0xE3,0x81,0xC1,0xC7,0x03,0x81,0xDC,0x0E,0x03,0xF8,0x38,0x03,0xE0, // '%'
	0x03,0xF0,0x01,0xFE,0x00,0xF3,0xC0,0x38,0x70,0x0E,0x1C,0x03,0x8F,0x00,0xE7,0x80,0x1F,0xC0,0x0F,0xC0,0x07,0xE0,0xC7,0xF8,0x39,0xE7,0x1C,0xF1,0xE7,0x3C,0x3B,0xCF,0x0F,0xE3,0xC1,0xF8,0x78,0x7E,0x0F,0xFF,0xF1,0xFC,0x3C, // '&'
	0xFF,0xFF,0xFF,0xF0, // '''
	0x0F,0x0F,0x07,0x87,0x83,0xC3,0xC1,0xE0,0xF0,0xF0,0x78,0x3C,0x1E,0x0F,0x07,0x83,0xC1,0xE0,0xF0,0x78,0x1E,0x0F,0x07,0x81,0xE0,0xF0,0x3C,0x1E,0x07,0x80, // '('
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
	  {  1035,  16,  19,  20,    2,  -19 }, // 'E'
	  {  1073,  14,  19,  18,    2,  -19 }, // 'F'
	  {  1107,  19,  19,  23,    1,  -19 }, // 'G'
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
};
const GFXfont Arimo_Bold_28 PROGMEM = {
(uint8_t  *)Arimo_Bold_28Bitmaps,(GFXglyph *)Arimo_Bold_28Glyphs,0x20, 0x7E, 33};
