BlackBrix/AKdiuno-V3/Arimo_Bold_32.h

// Created by http://oleddisplay.squix.ch/ Consider a donation
// In case of problems make sure that you are using the font file with the correct version!
const uint8_t Arimo_Bold_32Bitmaps[] PROGMEM = {

	// Bitmap Data:
	0x00, // ' '
	0xFF,0xFF,0xFF,0xFF,0xFF,0xFF,0xFF,0xF0,0x00,0xFF,0xFF, // '!'
	0xF1,0xFE,0x3F,0xC7,0xF8,0xFF,0x1F,0xE3,0xFC,0x7F,0x8F, // '"'
	0x03,0x06,0x01,0x83,0x01,0xC1,0x80,0xE1,0xC0,0x60,0xE0,0x30,0x61,0xFF,0xFE,0xFF,0xFF,0x7F,0xFF,0x86,0x0E,0x03,0x06,0x01,0x83,0x01,0xC3,0x87,0xFF,0xFB,0xFF,0xFD,0xFF,0xFE,0x18,0x30,0x1C,0x38,0x0E,0x1C,0x06,0x0C,0x03,0x06,0x03,0x83,0x00, // '#'
	0x00,0xC0,0x03,0xFC,0x07,0xFF,0x07,0xFF,0xC7,0xCD,0xF3,0xC6,0x79,0xE3,0x3C,0xF1,0x80,0x7C,0xC0,0x3F,0xE0,0x0F,0xFC,0x03,0xFF,0x80,0xFF,0xE0,0x0F,0xF8,0x03,0x7E,0x01,0x8F,0x10,0xC7,0xF8,0x63,0xDE,0x31,0xEF,0x99,0xF3,0xFF,0xF0,0xFF,0xF0,0x1F,0xE0,0x01,0x80,0x00,0xC0,0x00,0x60,0x00, // '$'
	0x1F,0x00,0x1C,0x07,0xF0,0x07,0x81,0xFF,0x01,0xE0,0x78,0xF0,0x38,0x0E,0x0E,0x0F,0x01,0xC1,0xC3,0xC0,0x38,0x38,0x70,0x07,0x07,0x1E,0x00,0xE0,0xE7,0x9F,0x1C,0x1C,0xE7,0xF3,0xC7,0x3D,0xFF,0x3F,0xEF,0x78,0xE3,0xF9,0xCE,0x0E,0x3E,0x79,0xC1,0xC0,0x1E,0x38,0x38,0x03,0x87,0x07,0x00,0xF0,0xE0,0xE0,0x3C,0x1C,0x1C,0x07,0x03,0xC7,0x01,0xE0,0x3F,0xE0,0x78,0x03,0xF8,0x0E,0x00,0x3E,0x00, // '%'
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
	  {  1360,  18,  22,  22,    2,  -22 }, // 'E'
	  {  1410,  16,  22,  20,    2,  -22 }, // 'F'
	  {  1454,  21,  22,  25,    1,  -22 }, // 'G'
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
};
const GFXfont Arimo_Bold_32 PROGMEM = {
(uint8_t  *)Arimo_Bold_32Bitmaps,(GFXglyph *)Arimo_Bold_32Glyphs,0x20, 0x7E, 37};
