BlackBrix/AKdiuno-V3/Arimo_Bold_64.h

// Created by http://oleddisplay.squix.ch/ Consider a donation
// In case of problems make sure that you are using the font file with the correct version!
const uint8_t Arimo_Bold_64Bitmaps[] PROGMEM = {

	// Bitmap Data:
	0x00, // ' '
	0x7F,0xBF,0xDF,0xEF,0xF7,0xFB,0xFD,0xFE,0xFF,0x7F,0xBF,0xDF,0xEF,0xF7,0xFB,0xFD,0xFE,0xFF,0x7F,0xBF,0xDF,0xEF,0xF7,0xFB,0xFD,0xFE,0xFF,0x7F,0xBF,0xDF,0xEF,0xF7,0xFB,0xFD,0xFE,0x00,0x00,0x00,0x00,0x00,0x00,0x07,0xFF,0xFF,0xFF,0xFF,0xFF,0xFF,0xFF,0xFF,0xF8, // '!'
	0xFF,0x07,0xFF,0xF8,0x3F,0xFF,0xC1,0xFF,0xFE,0x0F,0xFF,0xF0,0x7F,0xFF,0x83,0xFF,0xFC,0x1F,0xFF,0xE0,0xFF,0xFF,0x07,0xFF,0xF8,0x3F,0xFF,0xC1,0xFF,0xFE,0x0F,0xFF,0xF0,0x7F,0xFF,0x83,0xFF,0xFC,0x1F,0xFF,0xE0,0xFF, // '"'
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
	  {  3612,  10,  43,  22,    5,  -33 }, // ';'
	  {  3666,  32,  37,  39,    3,  -40 }, // '<'
	  {  3814,  32,  25,  39,    3,  -34 }, // '='
	  {  3914,  32,  37,  39,    3,  -40 }, // '>'
	  {  4062,  33,  46,  41,    3,  -46 }, // '?'
	  {  4252,  55,  56,  64,    4,  -46 }, // '@'
	  {  4637,  44,  45,  47,    1,  -45 }, // 'A'
	  {  4885,  39,  45,  47,    4,  -45 }, // 'B'
	  {  5105,  42,  47,  47,    3,  -46 }, // 'C'
	  {  5352,  39,  45,  47,    4,  -45 }, // 'D'
	  {  5572,  36,  45,  44,    4,  -45 }, // 'E'
	  {  5775,  33,  45,  40,    4,  -45 }, // 'F'
	  {  5961,  43,  47,  51,    3,  -46 }, // 'G'
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
};
const GFXfont Arimo_Bold_64 PROGMEM = {
(uint8_t  *)Arimo_Bold_64Bitmaps,(GFXglyph *)Arimo_Bold_64Glyphs,0x20, 0x7E, 74};
